fakufaku/ESP8266_MP3_DECODER/pcb/AudioThrowie.brd

## EAGLE design pcb/AudioThrowie.brd (2016-09-07)

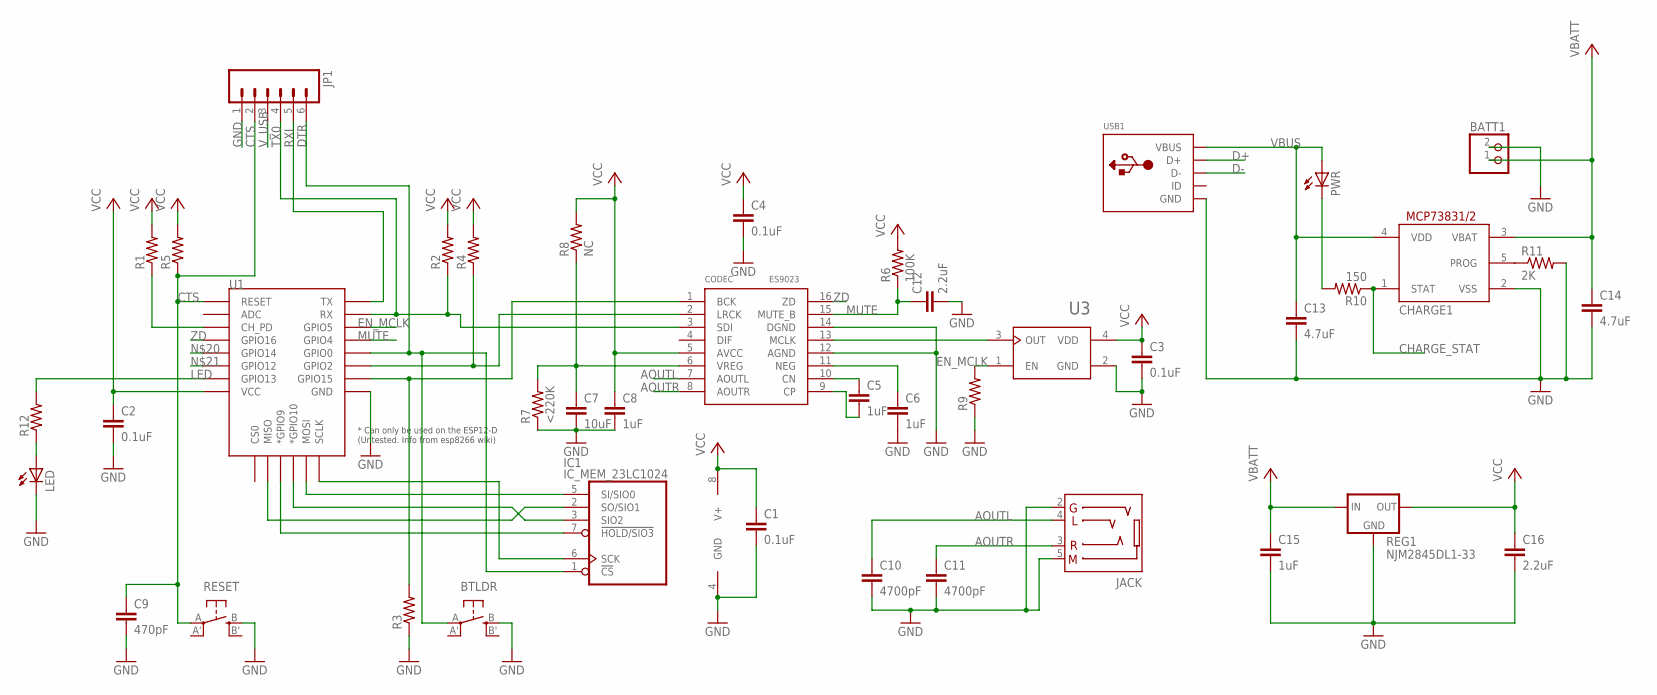
[picture p1: schematic AudioThrowie.sch]

Parts:
BATT1: JST_2PIN-THM; JST-PH-2-THM
BTLDR: SPST_TACT-EVQQ2; EVQ-Q2
C1, C2, C3, C4: 0.1uF; 0805
C5, C6, C8, C15: 1uF; 0805
C7: 10uF; 0805
C9: 470pF; 0805
C10, C11: 4700pF; 0805
C12, C16: 2.2uF; 0805
C13, C14: 4.7uF; 0805
CHARGE1: MCP73831/OT; SOT23-5L
CODEC: ES9023; SOP16
IC1: IC_MEM_23LC1024; SOIC-8
JACK: AUDIO-STEREO-JACK-3.5MM-4SLEEVES; PJ320D
JP1: M06LONGPADS; 1X06_LONGPADS
LED: LED3MM
PWR: LED3MM
R1, R2, R3, R4, R5, R9, R12: R-US_M0805; M0805
R6: 100K; M0805
R7: <220K; M0805
R8: NC; M0805
R10: 150; R0805
R11: 2K; R0603
REG1: NJM2845DL1-33; DPACK
RESET: SPST_TACT-EVQQ2; EVQ-Q2
U1: ESP12ESMD; ESP12E-SMD
U3: OSCILLATOR-AW-2.5X2; AW-CRYSTAL-2.5X2
USB1: USBMINIB; USB-MINIB

Connections:
AOUTL: C10.1, CODEC.7 (AOUTL), JACK.4 (TIP)
AOUTR: C11.1, CODEC.8 (AOUTR), JACK.3 (RING1)
CHARGE_STAT: CHARGE1.1 (STAT), R10.1
CTS: C9.1, JP1.2, R5.1, RESET.A, U1.RESET
D+: USB1.D+
D-: USB1.D-
DTR: BTLDR.A, IC1.1 (!CS), JP1.6, U1.GPIO0
EN_MCLK: R9.2, U1.GPIO5, U3.1 (EN)
GND: BATT1.2 (1), BTLDR.B (S), C1.2, C2.2, C3.2, C4.2, C6.2, C7.2, C8.2, C9.2, C10.2, C11.2, C12.2, C13.2, C14.2, C15.2, C16.2, CHARGE1.2 (VSS), CODEC.12 (AGND), CODEC.14 (DGND), IC1.4 (GND), JACK.2 (RING2), JACK.5 (SLEEVE), JP1.1, LED.K (C), R3.1, R7.1, R9.1, R11.2, REG1.4 (GND), RESET.B (S), U1.GND, U3.2 (GND), USB1.GND
LED: R12.2, U1.GPIO13
MUTE: C12.1, CODEC.15 (MUTE_B), R6.1, U1.GPIO4
unnamed: C5.1, CODEC.10 (CN)
unnamed: IC1.2 (SO/SIO1), U1.MISO
unnamed: IC1.3 (SIO2), U1.GPIO10 (*GPIO10)
unnamed: IC1.5 (SI/SIO0), U1.MOSI
unnamed: IC1.6 (SCK), U1.SCLK
unnamed: IC1.7 (!HOLD/SIO3), U1.GPIO9 (*GPIO9)
unnamed: CODEC.2 (LRCK), R4.1, U1.GPIO2
unnamed: C5.2, CODEC.9 (CP)
unnamed: CODEC.1 (BCK), R3.2, U1.GPIO15
unnamed: CODEC.13 (MCLK), U3.3 (OUT)
unnamed: C6.1, CODEC.11 (NEG)
unnamed: R1.1, U1.CH_PD
unnamed: PWR.K (C), R10.2
unnamed: CHARGE1.5 (PROG), R11.1
unnamed: C7.1, CODEC.6 (VREG), R7.2, R8.1
unnamed: LED.A, R12.1
RXI: JP1.5, U1.TXD0 (TX)
TX0: CODEC.3 (SDI), JP1.4, R2.1, U1.RXD0 (RX)
VBATT: BATT1.1 (2), C14.1, C15.1, CHARGE1.3 (VBAT), REG1.1 (IN)
VBUS: C13.1, CHARGE1.4 (VDD), PWR.A, USB1.VBUS
VCC: C1.1, C2.1, C3.1, C4.1, C8.1, C16.1, CODEC.5 (AVCC), IC1.8 (V+), R1.2, R2.2, R4.2, R5.2, R6.2, R8.2, REG1.3 (OUT), U1.VCC, U3.4 (VDD)
V_USB: JP1.3
ZD: CODEC.16 (ZD), U1.GPIO16

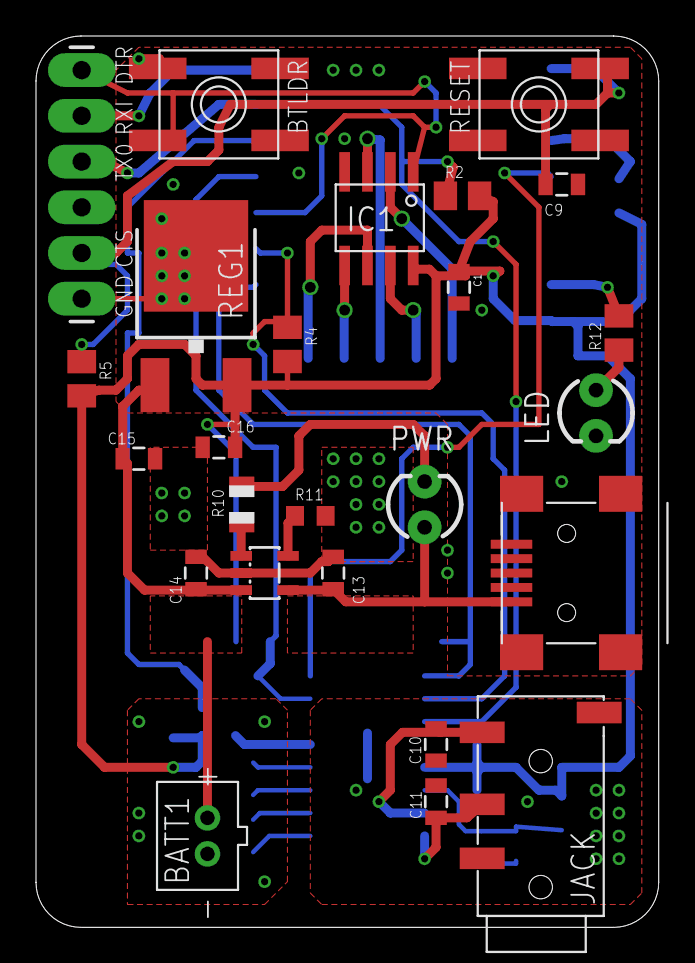
[picture p2: board AudioThrowie.brd from above]

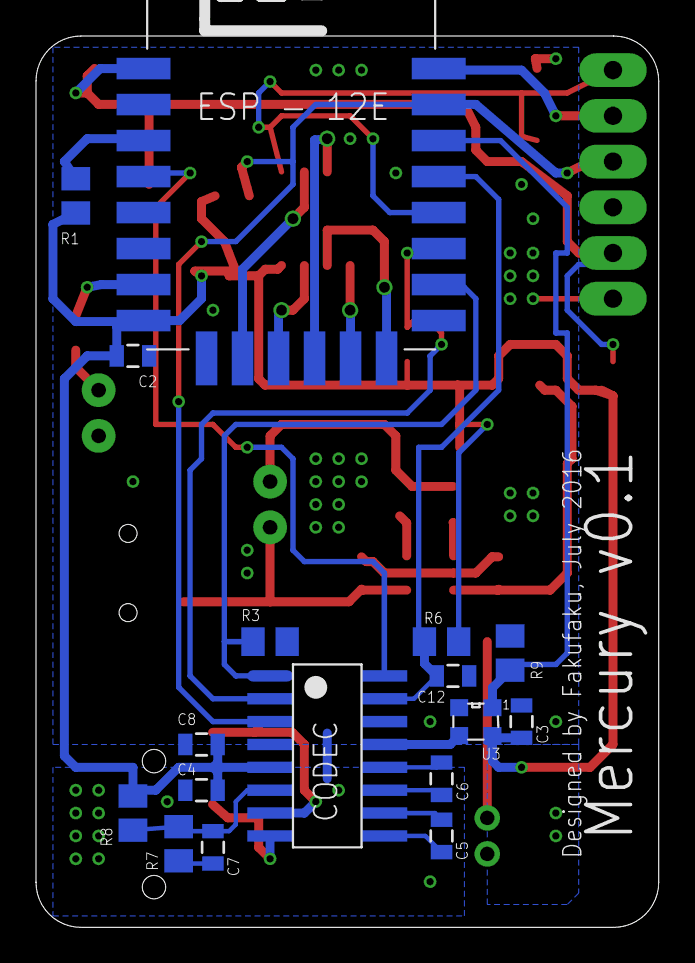
[picture p3: board AudioThrowie.brd from below]

Board: 2 copper layers, 34.6 x 49.5 mm, 42 parts (17 on the bottom side), 31 nets.
